reprap/darwin/firmware/Sanguino/README

This is a copy of the Arduino firmware.  It is a basis for building
the Sanguino firmware.

Adrian 4 Sept 2008
