reprap/darwin/electronics/Arduino-Sanguino/extruder-controller/extruder-controller.xls

Extruder Controller v2.2
Item # | Quantity | Designator | Part Number | Description | Package | Type
1 | 1 | IC1 | mouser: 863-MC7805CDTRKG | 7805DT | DPAK | SMT
2 | 2 | IC2, IC3 | digikey: 620-1062-ND | A3949 16-pin SOIC | SOIC | SMT
3 | 1 | IC4 | mouser: 595-SN75176AD | SN75176A 8-pin SOIC | SOIC | SMT
4 | 1 | IC5 | digikey: ATMEGA168-20AU-ND | Atmega168 32-pin TQFP | TQFP | fine pitch
5 | 2 | C1, C2 | mouser: 647-UUX1H101MNL1GS | 100uF electrolytic capacitor |  | SMT
6 | 8 | C3, C4, C6, C7, C10, C11, C14, C15 | mouser: 80-C1206C104K5R | 100nF ceramic capacitor 1206 | 1206 | SMT
7 | 2 | C5, C9 | mouser: 80-C1206C224K5R | .22uF ceramic capacitor 1206 | 1206 | SMT
8 | 1 | C8 | mouser: 647-UUT1H100MCL1GS | 10uF electrolytic capacitor |  | SMT
9 | 2 | C12, C13 | mouser: 77-VJ12A100V150J | 15pF ceramic capacitor 1206 | 1206 | SMT
10 | 9 | LED1-5 | mouser: 645-598-8270-107F | Green LED 1206 | 1206 | SMT
11 | 3 | Q1-3 | mouser: 863-NIF5003NT1G | NIF5003 | SOT-223 | SMT
12 | 1 | Q4 | mouser: 695-HC49US-16-U | 16Mhz crystal |  | Thru-hole
13 | 5 | R2, R3, R6, R20, R21 | mouser: 263-4.7K-RC | 4.7K ohm resistor 1206 | 1206 | SMT
14 | 3 | R4, R5, R7 | mouser: 290-10K-RC | 10K ohm resistor 1206 | 1206 | SMT
15 | 11 | R8-R15, R29-R31 | mouser: 290-1.0K-RC | 1K ohm resistor 1206 | 1206 | SMT
16 | 1 | ICSP | mouser: 649-75869-131LF | 6 pin IDC header | header | Thru-hole
17 | 1 | QUADRATURE | mouser: 649-75869-101LF | 10 pin IDC header | header | Thru-hole
18 | 25 |  | digikey: A26514-40-ND | .100 breakaway header | header | Thru-hole
19 | 1 | MOSFETS | mouser: 571-2828376 | 6 pin .200" terminal block | terminals | Thru-hole
20 | 1 | MOTORS | mouser: 571-2828374 | 4 pin .200" terminal block | terminals | Thru-hole
21 | 1 | THERMISTOR | mouser: 571-2828372 | 2 pin .200" connector | terminals | Thru-hole
22 | 1 | RESET | mouser: 653-B3F-1000 | Omron B3F-1000 Button | Snap-in | Thru-hole
23 | 1 |  | mouser: 571-5555164-1 | RJ45 Jack | Snap-in | Thru-hole
24 | 1 | R16 | mouser: 72-T70YE-10K | 10K trimpot |  | Thru-hole
