reprap/darwin/mechanics/bits-from-bytes-designs/STLs-for-reprapping/extruder/main-plate.stl

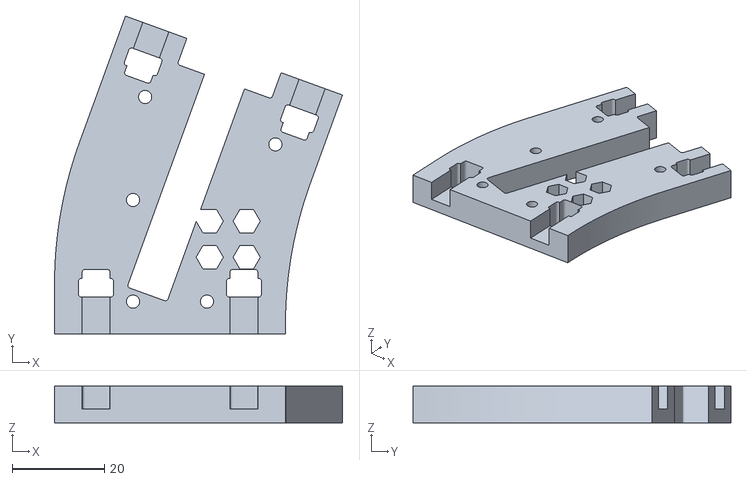
[picture p1: CAD file, 2009-10-07]
mechanics/bits-from-bytes-designs/STLs-for-reprapping/extruder/main-plate.stl
62.3 x 68.8 x 8.00
