reprap/darwin/mechanics/bits-from-bytes-designs/STLs-for-reprapping/extruder/main-plate-AND-top-plate.stl

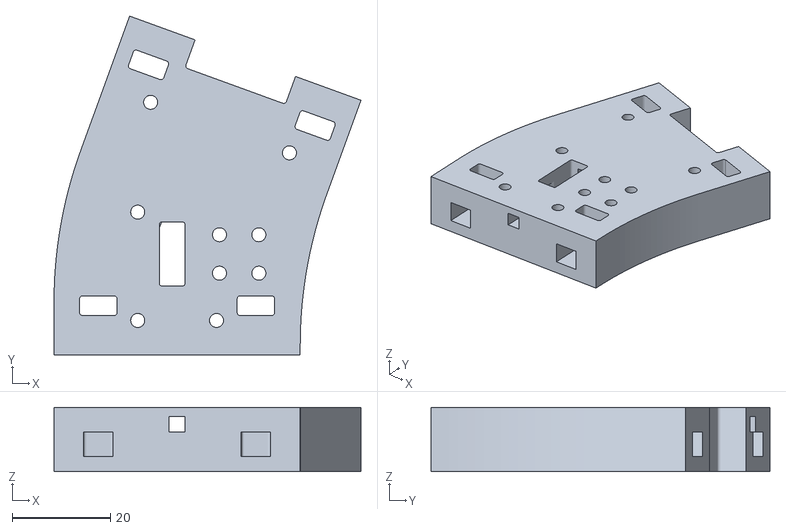
[picture p2: CAD file, 2009-10-07]
mechanics/bits-from-bytes-designs/STLs-for-reprapping/extruder/main-plate-AND-top-plate.stl
62.3 x 68.8 x 13.0
