reprap/darwin/mechanics/bits-from-bytes-designs/DXFs-for-laser-cutter/extruder-8mm-laser-cut-acrylic.dxf

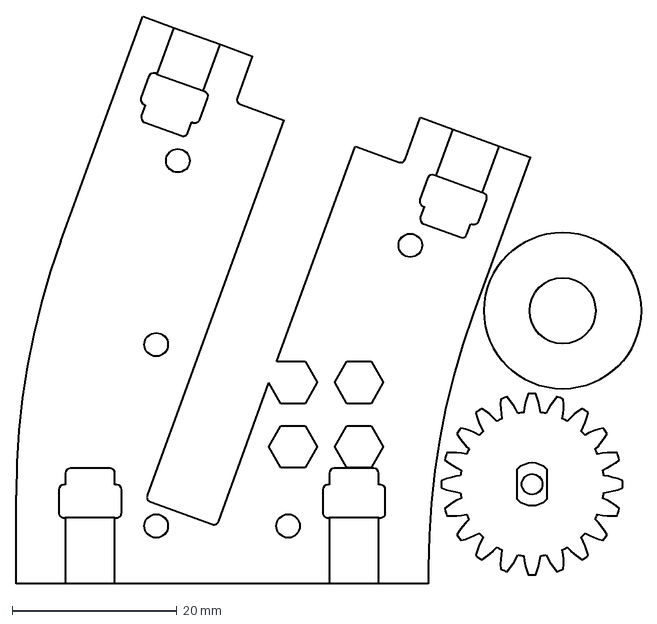
[picture p3: CAD file, 2009-10-07]
mechanics/bits-from-bytes-designs/DXFs-for-laser-cutter/extruder-8mm-laser-cut-acrylic.dxf
75.8 x 68.8 mm
