reprap/darwin/mechanics/bits-from-bytes-designs/STLs-for-reprapping/extruder/pressure-clamp-plate.stl

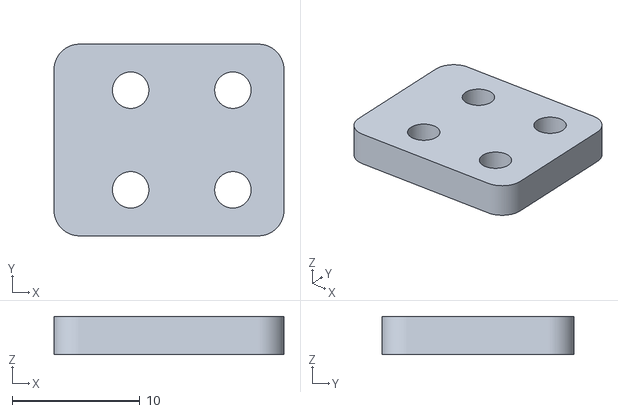
[picture p4: CAD file, 2009-10-07]
mechanics/bits-from-bytes-designs/STLs-for-reprapping/extruder/pressure-clamp-plate.stl
18.0 x 15.0 x 3.00
