reprap/darwin/mechanics/cartesian-robot/bed-template.dxf

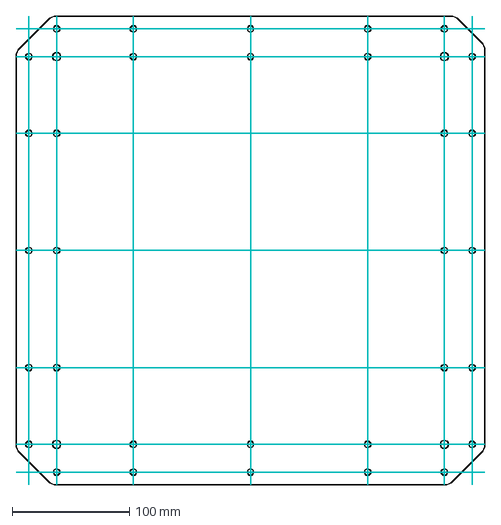
[picture p5: CAD file, 2009-10-07]
mechanics/cartesian-robot/bed-template.dxf
400.0 x 400.0 mm
