reprap/darwin/mechanics/paste-extruder/DXFs/balloon-support.dxf

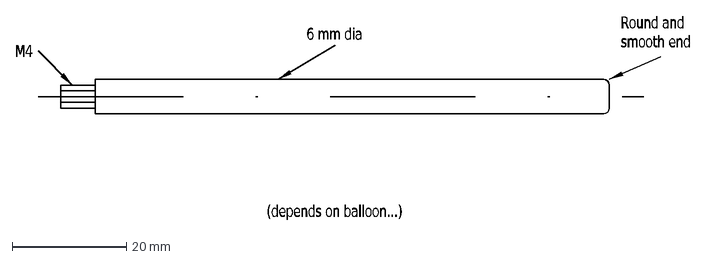
[picture p6: CAD file, 2009-10-07]
mechanics/paste-extruder/DXFs/balloon-support.dxf
M4
6\~mm\~dia
Round\~and smooth\~end
(depends\~on\~balloon...)
