reprap/darwin/mechanics/pinch-wheel-extruder/DXFs/brass-heater-barrel.dxf

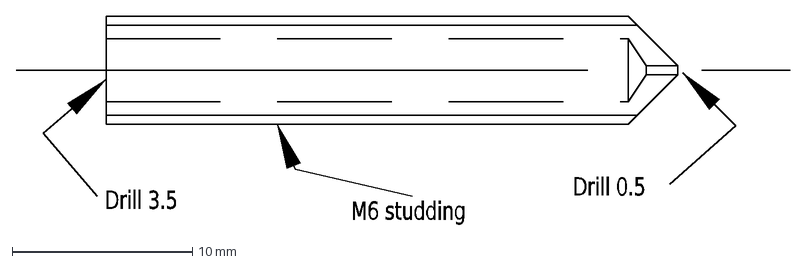
[picture p7: CAD file, 2009-10-07]
mechanics/pinch-wheel-extruder/DXFs/brass-heater-barrel.dxf
Drill\~3.5
M6\~studding
Drill\~0.5
