reprap/darwin/mechanics/polymer-extruder/DXFs/bearing.dxf

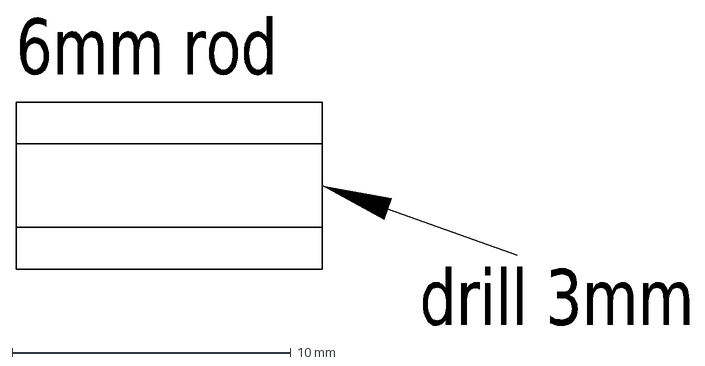
[picture p8: CAD file, 2009-10-07]
mechanics/polymer-extruder/DXFs/bearing.dxf
6mm\~rod
drill\~3mm
