reprap/darwin/mechanics/bits-from-bytes-designs/DXFs-for-laser-cutter/extruder-3mm-laser-cut-acrylic.dxf

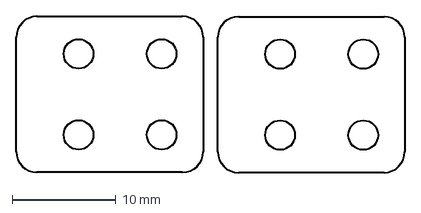
[picture p9: CAD file, 2009-10-07]
mechanics/bits-from-bytes-designs/DXFs-for-laser-cutter/extruder-3mm-laser-cut-acrylic.dxf
37.4 x 15.0 mm
