reprap/darwin/mechanics/bits-from-bytes-designs/STLs-for-reprapping/extruder/insulator-retainer.stl

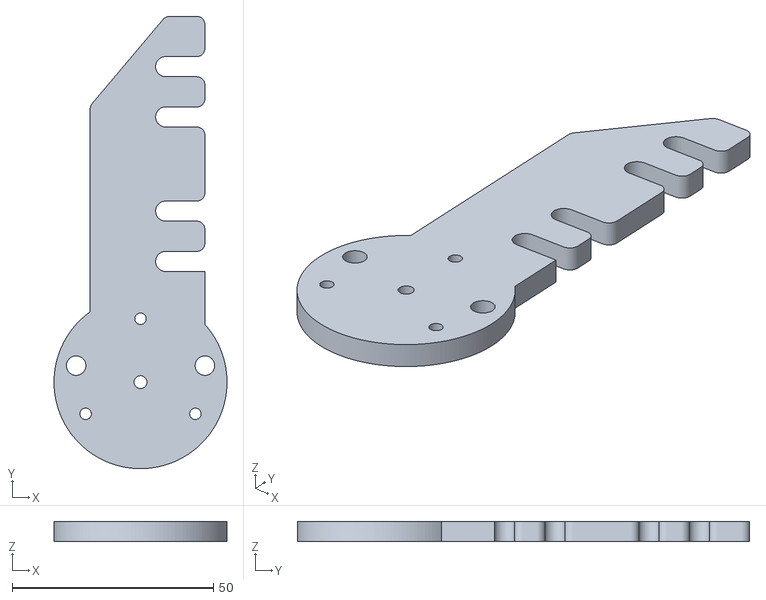
[picture p10: CAD file, 2009-10-07]
mechanics/bits-from-bytes-designs/STLs-for-reprapping/extruder/insulator-retainer.stl
43.0 x 112.4 x 5.00
