reprap/darwin/mechanics/paste-extruder/DXFs/nozzle-union.dxf

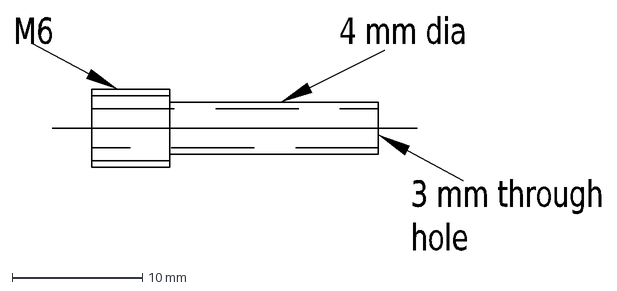
[picture p11: CAD file, 2009-10-07]
mechanics/paste-extruder/DXFs/nozzle-union.dxf
M6
3\~mm\~through hole
4\~mm\~dia
