reprap/darwin/mechanics/pinch-wheel-extruder/DXFs/thermal-barrier.dxf

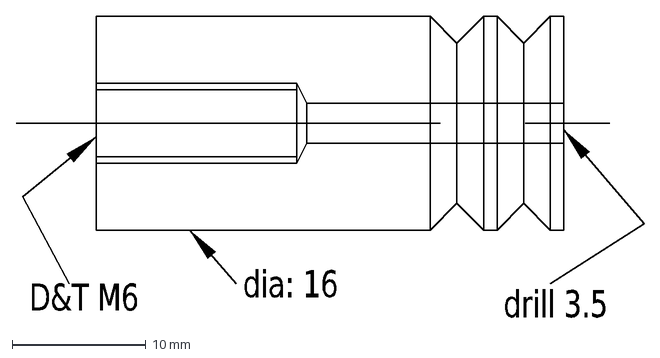
[picture p12: CAD file, 2009-10-07]
mechanics/pinch-wheel-extruder/DXFs/thermal-barrier.dxf
D&T\~M6
dia:\~16
drill\~3.5
