reprap/darwin/mechanics/polymer-extruder/DXFs/barrel.dxf

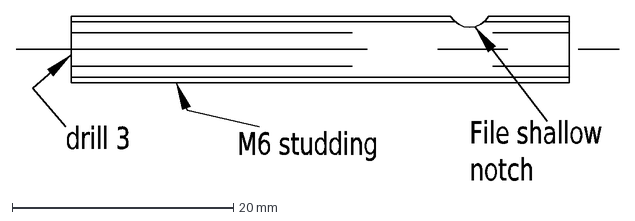
[picture p13: CAD file, 2009-10-07]
mechanics/polymer-extruder/DXFs/barrel.dxf
drill\~3
M6\~studding
File\~shallow notch
