reprap/darwin/mechanics/bits-from-bytes-designs/DXFs-for-laser-cutter/cartesian-bot-5mm-laser-cut-acetal.dxf

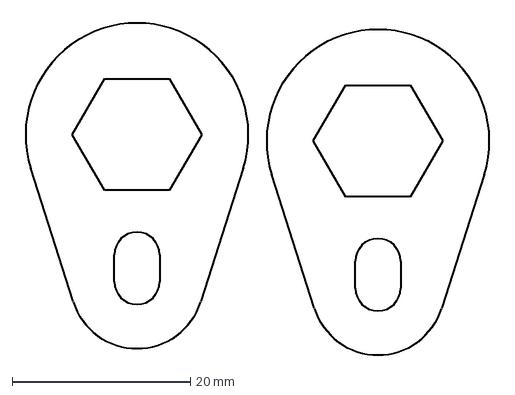
[picture p14: CAD file, 2009-10-07]
mechanics/bits-from-bytes-designs/DXFs-for-laser-cutter/cartesian-bot-5mm-laser-cut-acetal.dxf
54.1 x 38.0 mm
