reprap/darwin/mechanics/bits-from-bytes-designs/STLs-for-reprapping/extruder/spur-gear20t.stl

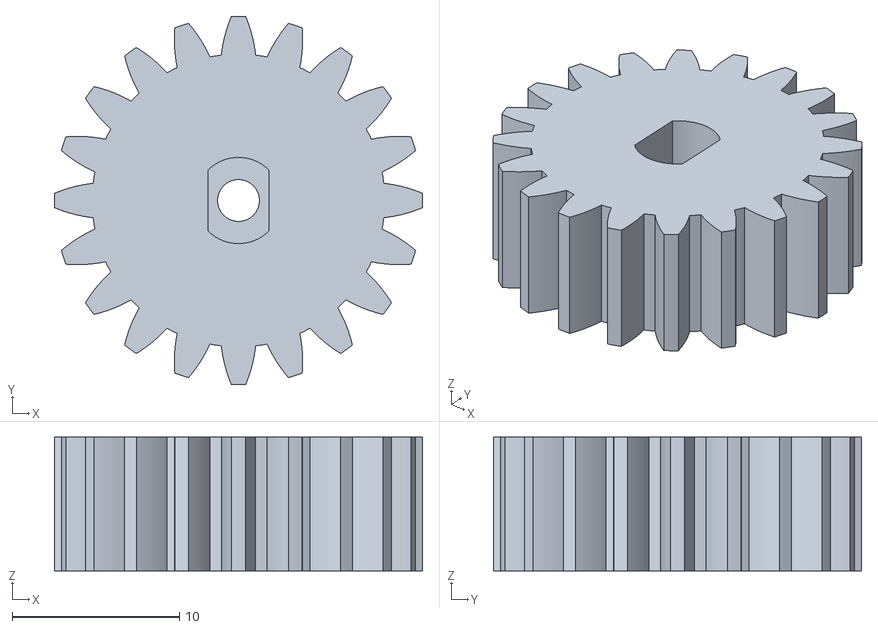
[picture p15: CAD file, 2009-10-07]
mechanics/bits-from-bytes-designs/STLs-for-reprapping/extruder/spur-gear20t.stl
22.0 x 22.0 x 8.00
