reprap/darwin/mechanics/paste-extruder/DXFs/tube-union.dxf

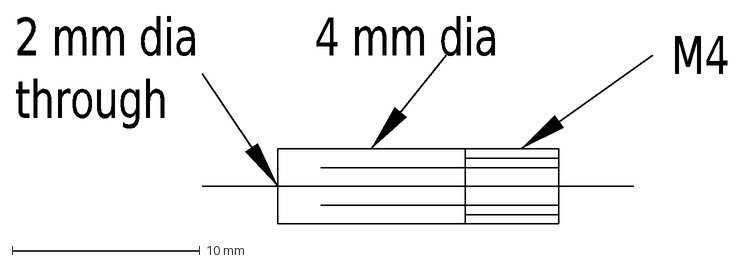
[picture p16: CAD file, 2009-10-07]
mechanics/paste-extruder/DXFs/tube-union.dxf
2\~mm\~dia through
4\~mm\~dia
M4
