reprap/darwin/mechanics/polymer-extruder/DXFs/ptfe-insulating-block.dxf

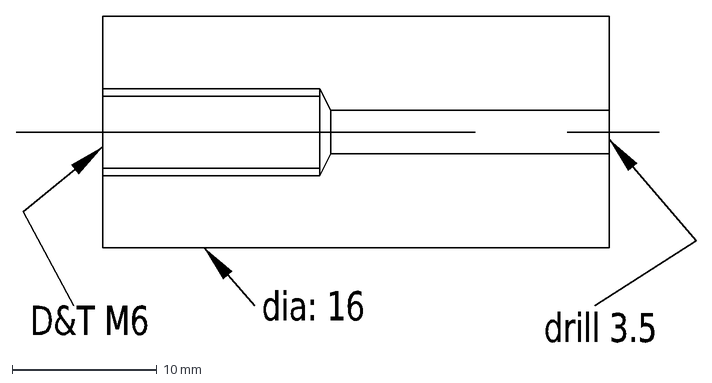
[picture p17: CAD file, 2009-10-07]
mechanics/polymer-extruder/DXFs/ptfe-insulating-block.dxf
D&T\~M6
dia:\~16
drill\~3.5
