reprap/darwin/mechanics/bits-from-bytes-designs/DXFs-for-laser-cutter/cartesian-bot-top-bed-8mm-laser-cut-acrylic.dxf

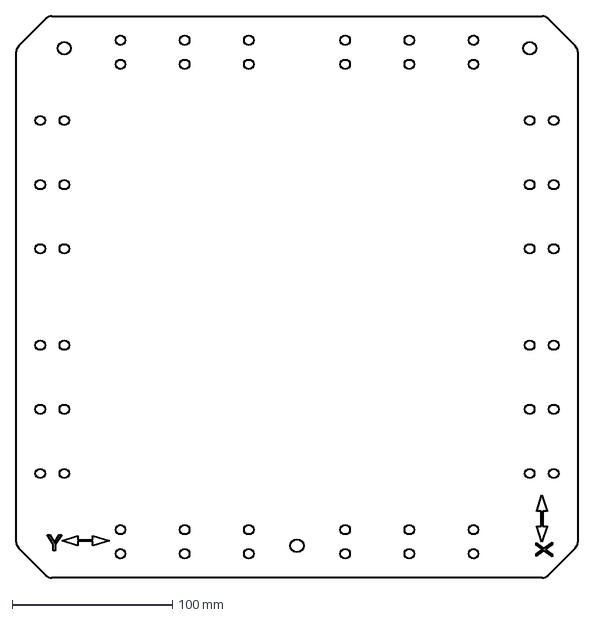
[picture p18: CAD file, 2009-10-07]
mechanics/bits-from-bytes-designs/DXFs-for-laser-cutter/cartesian-bot-top-bed-8mm-laser-cut-acrylic.dxf
350.0 x 350.0 mm
