reprap/darwin/mechanics/paste-extruder/DXFs/balloon-holder.dxf

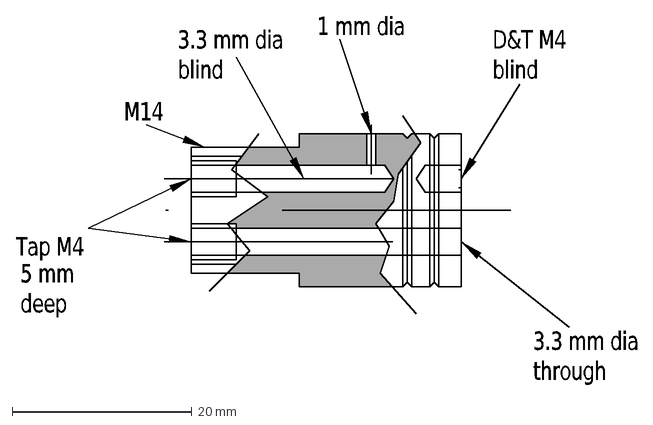
[picture p20: CAD file, 2009-10-07]
mechanics/paste-extruder/DXFs/balloon-holder.dxf
1\~mm\~dia
3.3\~mm\~dia blind
M14
Tap\~M4
3.3\~mm\~dia through
D&T\~M4 blind
5\~mm deep
