reprap/darwin/mechanics/bits-from-bytes-designs/DXFs-for-laser-cutter/extruder-5mm-laser-cut-acrylic.dxf

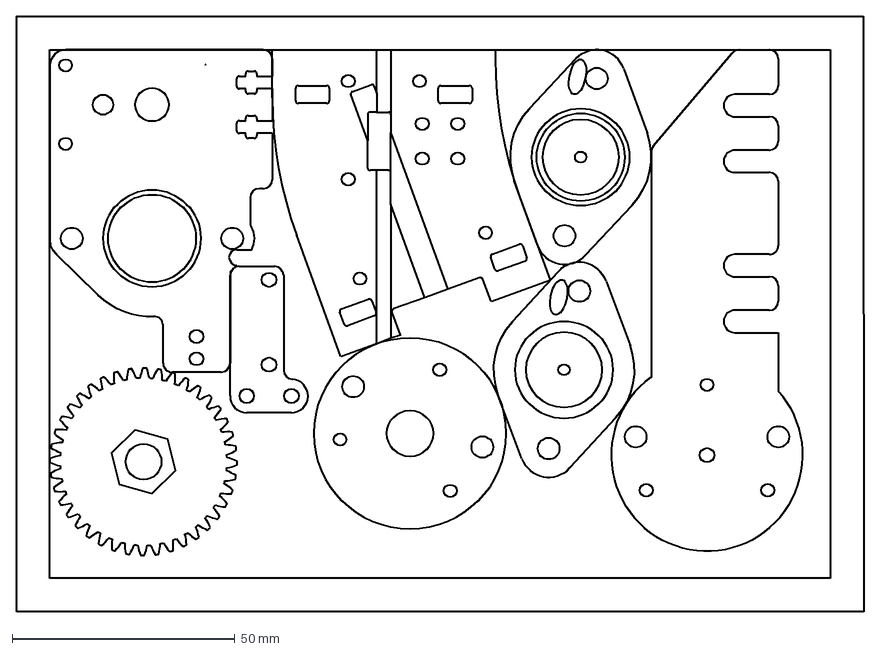
[picture p21: CAD file, 2009-10-07]
mechanics/bits-from-bytes-designs/DXFs-for-laser-cutter/extruder-5mm-laser-cut-acrylic.dxf
190.0 x 133.5 mm
