reprap/darwin/mechanics/bits-from-bytes-designs/STLs-for-reprapping/extruder/opto-wheel-spacer.stl

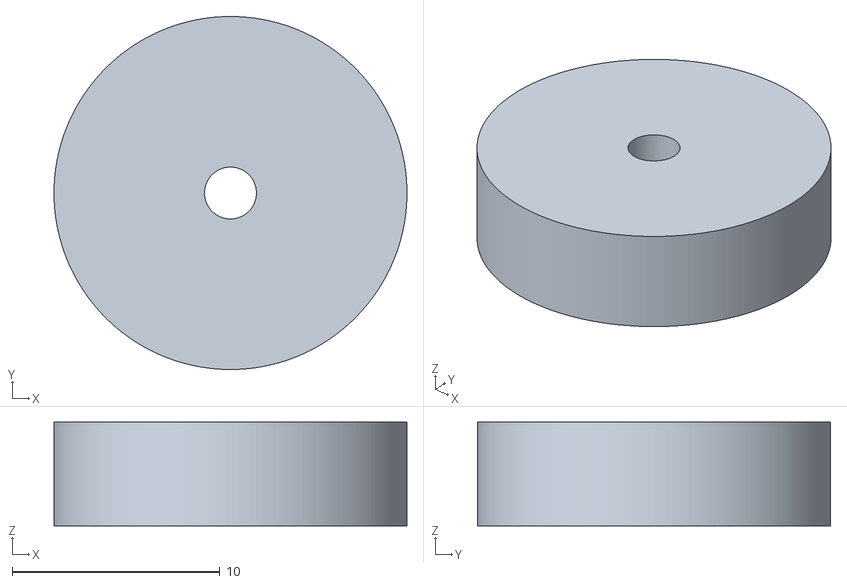
[picture p22: CAD file, 2009-10-07]
mechanics/bits-from-bytes-designs/STLs-for-reprapping/extruder/opto-wheel-spacer.stl
17.0 x 17.0 x 5.00
