reprap/darwin/mechanics/polymer-extruder/DXFs/nozzle.dxf

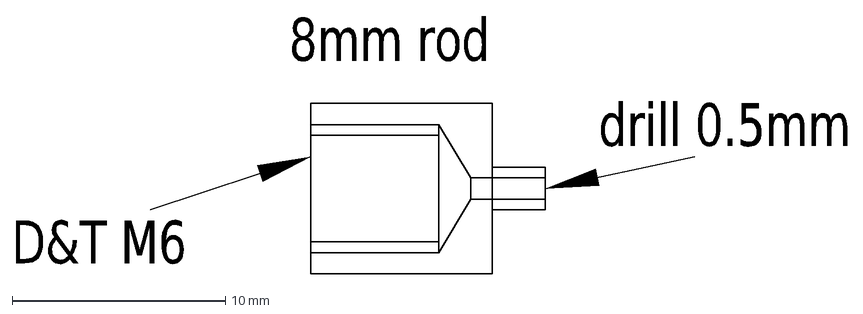
[picture p23: CAD file, 2009-10-07]
mechanics/polymer-extruder/DXFs/nozzle.dxf
8mm\~rod
D&T\~M6
drill\~0.5mm
