reprap/darwin/mechanics/bits-from-bytes-designs/DXFs-for-laser-cutter/cartesian-bot-5mm-laser-cut-acrylic.dxf

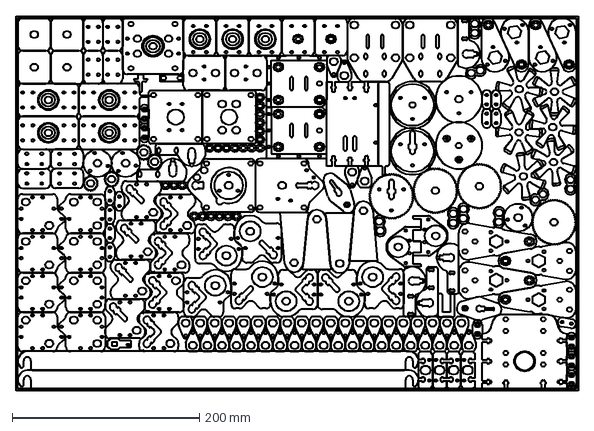
[picture p24: CAD file, 2009-10-07]
mechanics/bits-from-bytes-designs/DXFs-for-laser-cutter/cartesian-bot-5mm-laser-cut-acrylic.dxf
600.0 x 400.0 mm
