reprap/darwin/mechanics/polymer-extruder/DXFs/cross-valve-nozzle.dxf

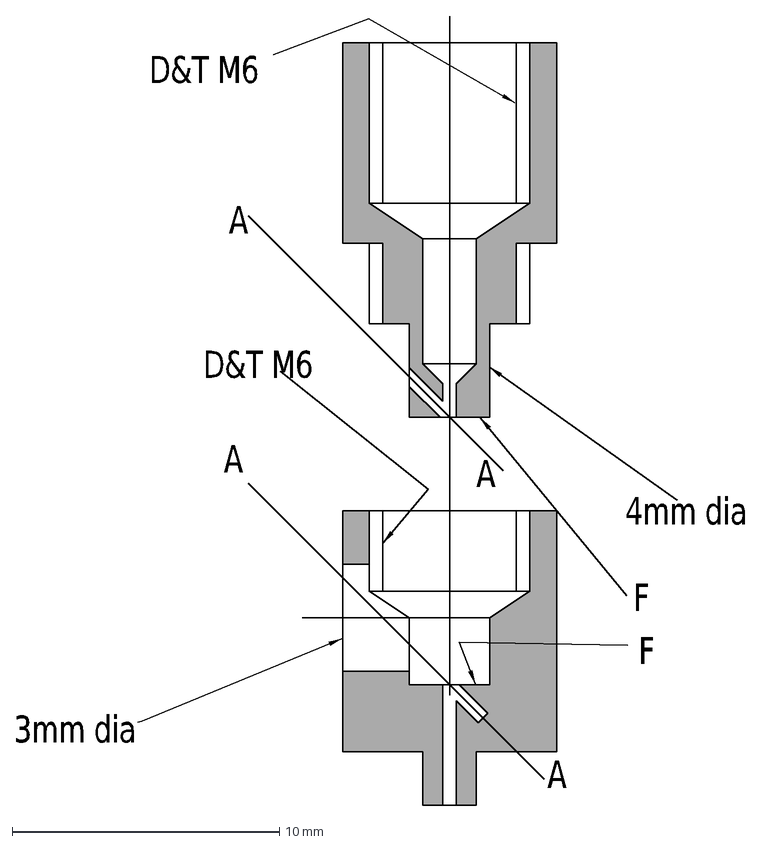
[picture p25: CAD file, 2009-10-07]
mechanics/polymer-extruder/DXFs/cross-valve-nozzle.dxf
D&T\~M6
3mm\~dia
A
4mm\~dia
F
