reprap/darwin/mechanics/bits-from-bytes-designs/DXFs-for-laser-cutter/cartesian-bot-bottom-bed-8mm-laser-cut-acrylic.dxf

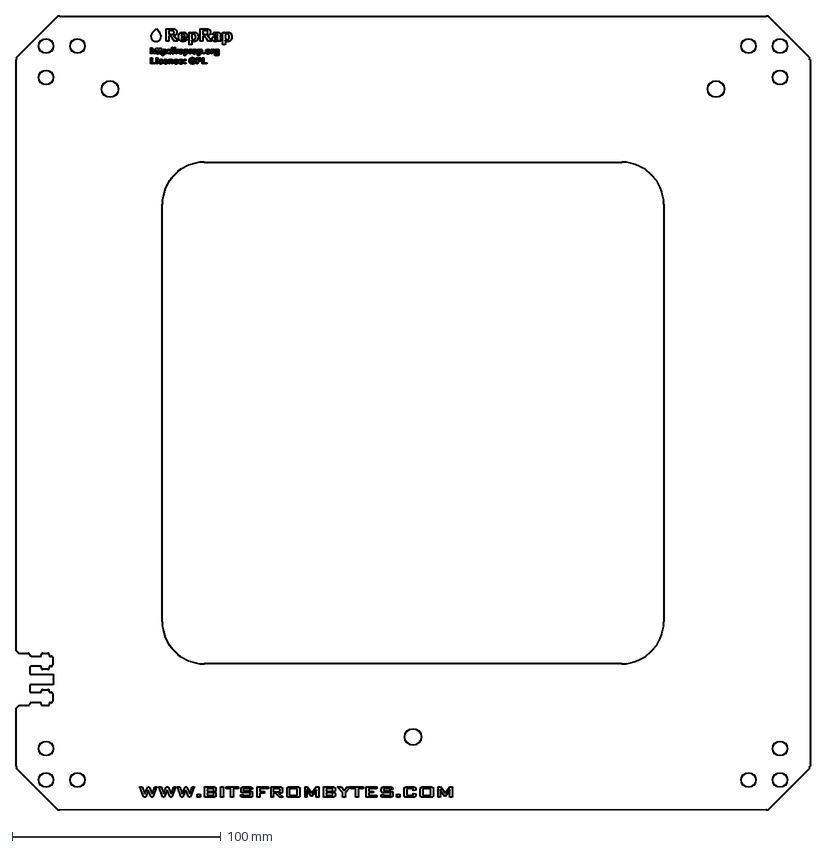
[picture p26: CAD file, 2009-10-07]
mechanics/bits-from-bytes-designs/DXFs-for-laser-cutter/cartesian-bot-bottom-bed-8mm-laser-cut-acrylic.dxf
380.0 x 380.0 mm
