reprap/darwin/mechanics/bits-from-bytes-designs/STLs-for-reprapping/extruder/opto-slotted-disc.stl

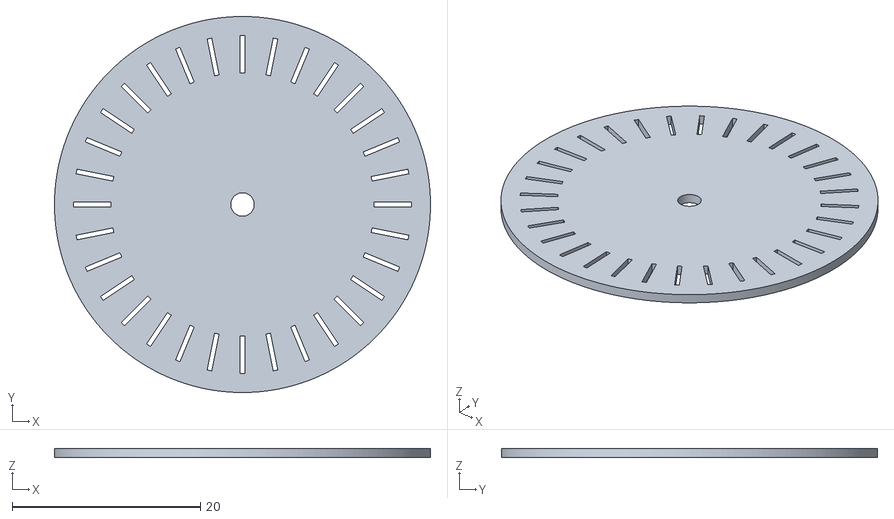
[picture p27: CAD file, 2009-10-07]
mechanics/bits-from-bytes-designs/STLs-for-reprapping/extruder/opto-slotted-disc.stl
40.0 x 40.0 x 1.00
