reprap/darwin/mechanics/bits-from-bytes-designs/STLs-for-reprapping/extruder/opto-wheel.stl

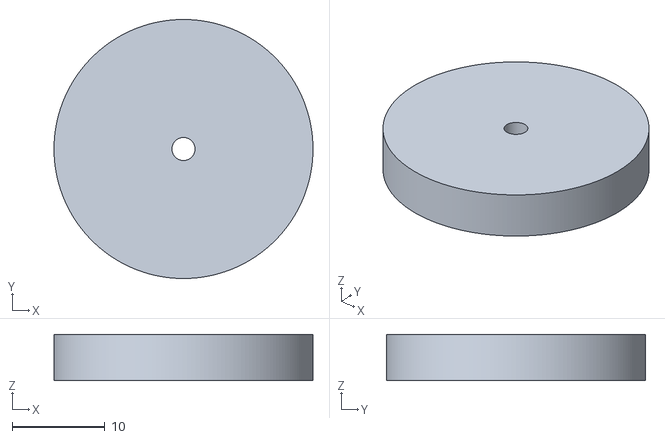
[picture p28: CAD file, 2009-10-07]
mechanics/bits-from-bytes-designs/STLs-for-reprapping/extruder/opto-wheel.stl
28.0 x 28.0 x 5.00
