reprap/darwin/mechanics/bits-from-bytes-designs/STLs-for-reprapping/extruder/top-plate.stl

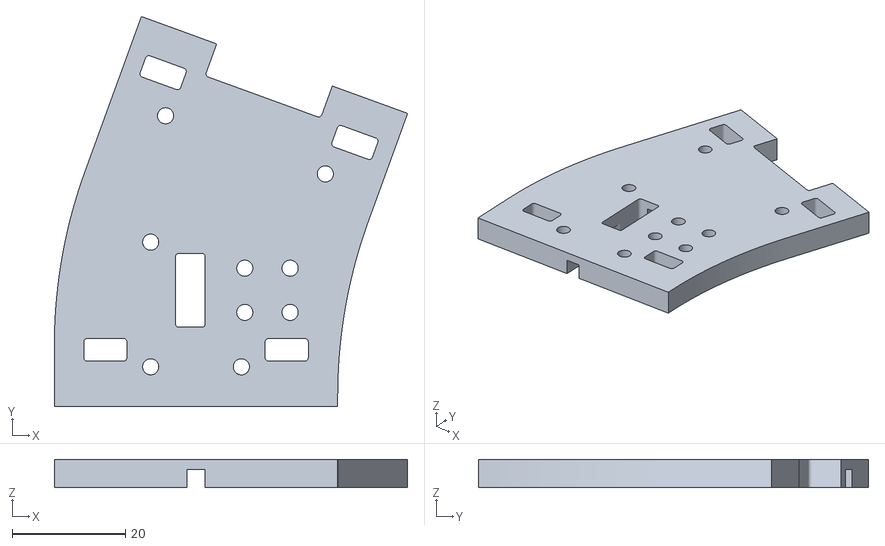
[picture p29: CAD file, 2009-10-07]
mechanics/bits-from-bytes-designs/STLs-for-reprapping/extruder/top-plate.stl
62.3 x 68.8 x 5.00
