reprap/darwin/mechanics/bits-from-bytes-designs/STLs-for-reprapping/extruder/insulator-top-disc.stl

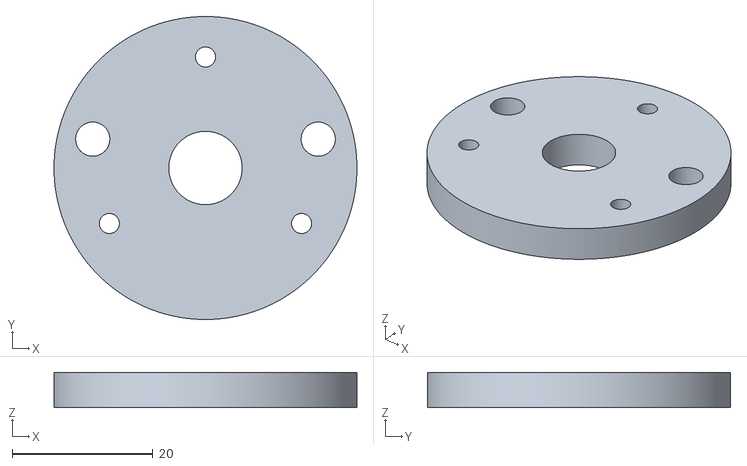
[picture p31: CAD file, 2009-10-07]
mechanics/bits-from-bytes-designs/STLs-for-reprapping/extruder/insulator-top-disc.stl
43.0 x 43.0 x 5.00
