reprap/darwin/mechanics/bits-from-bytes-designs/STLs-for-reprapping/extruder/bearing-floating-plate-AND-bearing-lower-clamp-plate.stl

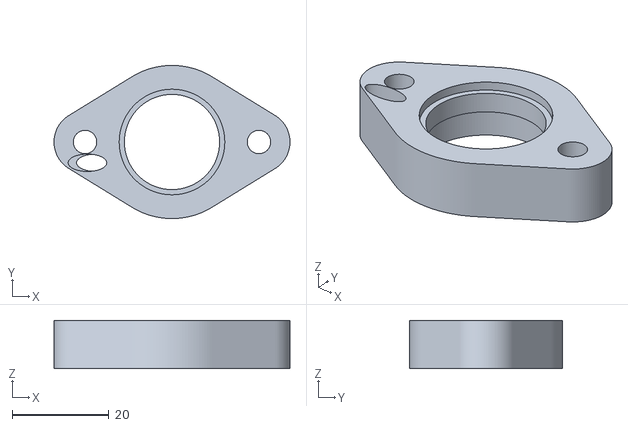
[picture p32: CAD file, 2009-10-07]
mechanics/bits-from-bytes-designs/STLs-for-reprapping/extruder/bearing-floating-plate-AND-bearing-lower-clamp-plate.stl
48.8 x 31.7 x 10.0
