reprap/darwin/mechanics/bits-from-bytes-designs/STLs-for-reprapping/extruder/bearing-lower-clamp-plate.stl

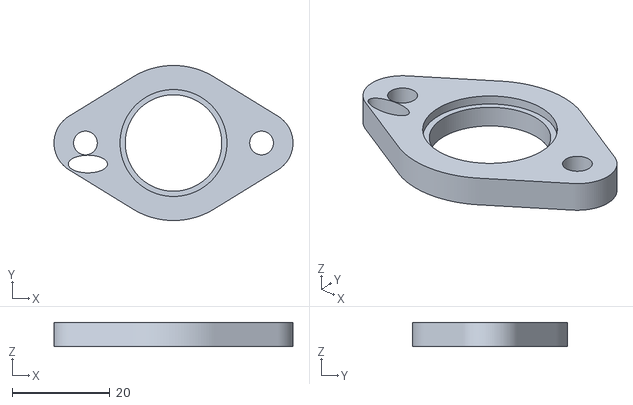
[picture p33: CAD file, 2009-10-07]
mechanics/bits-from-bytes-designs/STLs-for-reprapping/extruder/bearing-lower-clamp-plate.stl
48.8 x 31.7 x 5.00
