reprap/darwin/mechanics/bits-from-bytes-designs/STLs-for-reprapping/extruder/motor-mount.stl

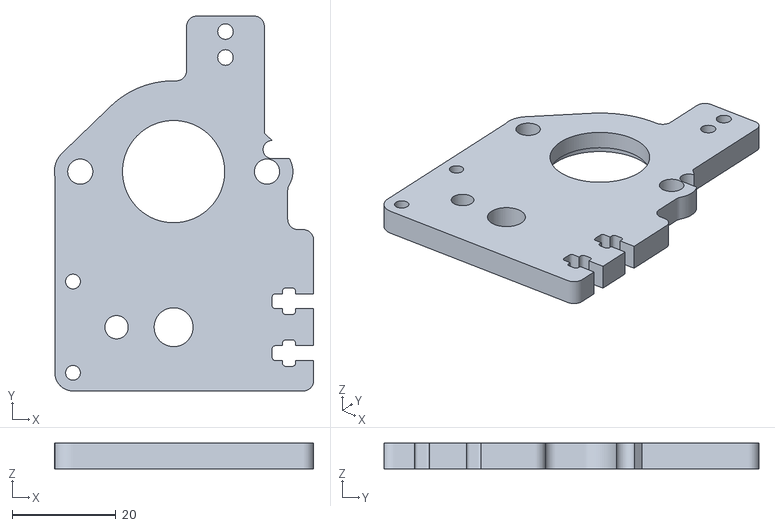
[picture p34: CAD file, 2009-10-07]
mechanics/bits-from-bytes-designs/STLs-for-reprapping/extruder/motor-mount.stl
50.0 x 72.3 x 5.00
