reprap/darwin/mechanics/bits-from-bytes-designs/STLs-for-reprapping/extruder/spur-gear40t.stl

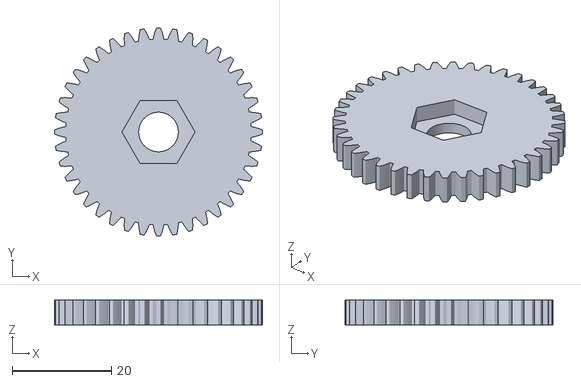
[picture p35: CAD file, 2009-10-07]
mechanics/bits-from-bytes-designs/STLs-for-reprapping/extruder/spur-gear40t.stl
42.0 x 42.0 x 5.00
