reprap/darwin/mechanics/bits-from-bytes-designs/STLs-for-reprapping/extruder/opto-mount.stl

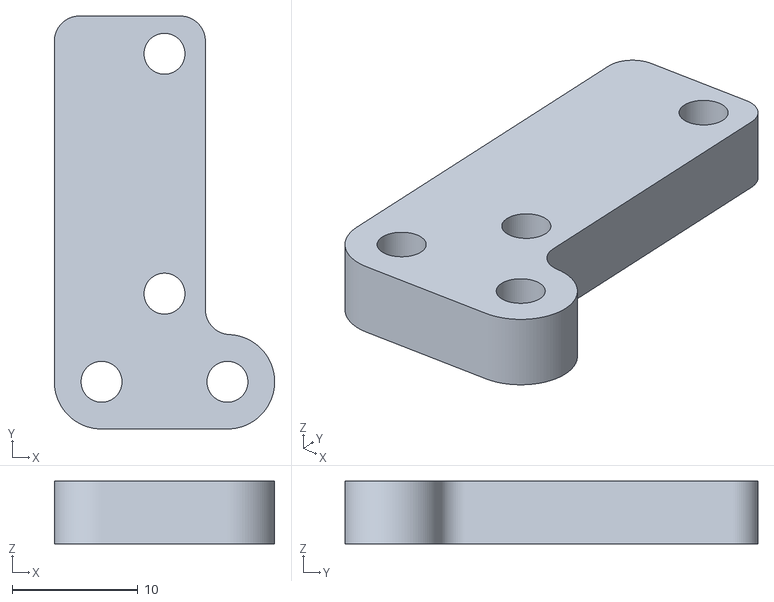
[picture p36: CAD file, 2009-10-07]
mechanics/bits-from-bytes-designs/STLs-for-reprapping/extruder/opto-mount.stl
17.5 x 32.8 x 5.00
