reprap/darwin/mechanics/bits-from-bytes-designs/STLs-for-reprapping/extruder/reaction-plate.stl

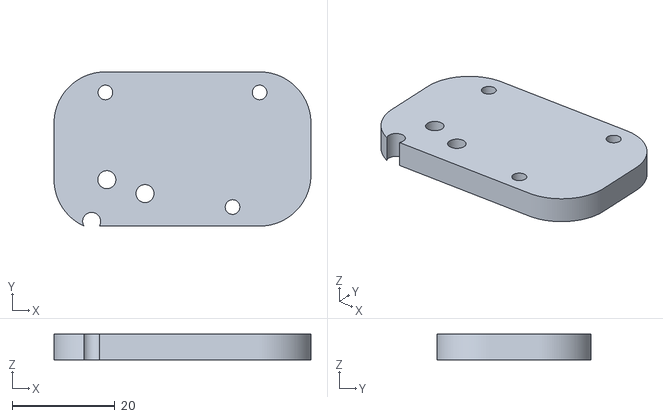
[picture p37: CAD file, 2009-10-07]
mechanics/bits-from-bytes-designs/STLs-for-reprapping/extruder/reaction-plate.stl
50.0 x 30.0 x 5.00
