reprap/darwin/mechanics/bits-from-bytes-designs/STLs-for-reprapping/extruder/drive-spacer.stl

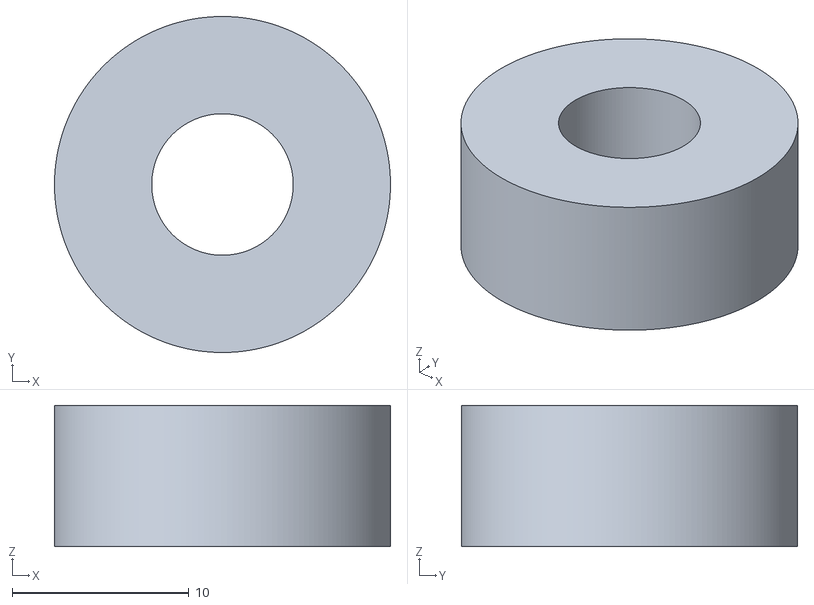
[picture p38: CAD file, 2009-10-07]
mechanics/bits-from-bytes-designs/STLs-for-reprapping/extruder/drive-spacer.stl
19.0 x 19.0 x 8.00
