reprap/darwin/(list of files, cad)

Other CAD files:
mechanics/polymer-extruder/DXFs/screw-drive.dxf
