reprap/darwin/electronics/PIC/opto-endstop/opto_endstop.sch

## KiCad design electronics/PIC/opto-endstop/opto_endstop.sch (2009-10-07)

Schematic: opto_endstop.sch

Parts:
K1: CONN_3
R1: 10K
R2: 220R
U1: H21LOI
