reprap/darwin/electronics/PIC/powercomms/powercomms.sch

## KiCad design electronics/PIC/powercomms/powercomms.sch (2009-10-07)

Schematic: powercomms.sch

Parts:
C1, C2, C3, C4, C5: 1uF
C6, C8: 2200uF
C7, C9: 0.1uF
D1, D2, D3: LED
D4, D5: BILED
J1: DB9
M06: MOLEX_4PIN
P2, P3, P4, P5, P6, P7, P8, P9, P10: CONN_2
R1: 560R
R2, R3: 1K8
R4, R5: 5K6
U1: 78L05
U2: MAX232

Notes on the sheet:
Rx/Tx Debug LEDs
RS232 Debug LEDs
Power-on LED
RS232 to TTL converter
Power in and voltage regulator
Power output connectors
RS232 socket
