reprap/darwin/electronics/PIC/stepper-tester/stepper-test-substitute.sch

## KiCad design electronics/PIC/stepper-tester/stepper-test-substitute.sch (2009-10-07)

Schematic: stepper-test-substitute.sch

Parts:
D1, D2: Green LED
D3, D4: Red LED
P1: CONN_4
R1, R2: 560 R
