reprap/darwin/electronics/PIC/universal-controller/universal.sch

## KiCad design electronics/PIC/universal-controller/universal.sch (2009-10-07)

Schematic: universal.sch

Parts:
C1: 1000uF 25v
C2: 100uF 12v
C3: 1uF
C4, C5, C6: 0.1uF
D1, D2, D3, D4, D5, D6, D7, D8: 1N4005
D9, D10, D11, D12, D14, D15, D16: LED
D17: BILED
K1, K2: CONN_3
P1, P2, P3, P4, P5, P6, P7, P8: CONN_2
P9: CONN_4
P10: CONN_5
P11: CONN_6
Q1, Q2, Q3: TIP110
R1, R2: 10K
R3: 180R
R4, R5, R6, R9: 220R
R10, R11: 4K7
R12, R17, R18: 560R
R13, R14, R15, R16: 1K8
U1: 78L05
U2: L298N

Notes on the sheet:
and solenoid
RA0 to RB6 here instead to drive fan
Connect the end of R9 that goes to
/ solenoid
PIC
Debug LEDs
Slave stepper
Alt. Extrude
ICSP
Alt. Fan
Min / Extrude speed
Max / Mat. Out
Heater
Sync
Thermistor
Step B / Fan
Step A / Extrude
12V power
