reprap/darwin/(commit log)

2009-10-07 Repository reorganisation - creating a darwin folder for the Darwin electronics, firmware, and mechanics.
    [$savepcb.brd, 3axis_snap.sch, Configuration.h, arduino-breakout.brd, arduino-breakout.sch, arduino-sanguino-pinouts.ods, balloon-holder.dxf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]
2009-10-27 Updating the Darwin 5D G code firmware.
    [configuration.h]
2010-12-11 Removed svn:executable property from many more files.
    [bearing-floating-plate-AND-bearing-lower-clamp-plate.stl, bearing-floating-plate.stl, bearing-lower-clamp-plate.stl, drive-spacer.stl, insulator-retainer.stl, insulator-top-disc-AND-insulator-retainer.stl, insulator-top-disc.stl, main-plate-AND-top-plate.stl]
